grilloandrea6/Crazyflie_FPGA_Deck/Deck_FPGA.pdf

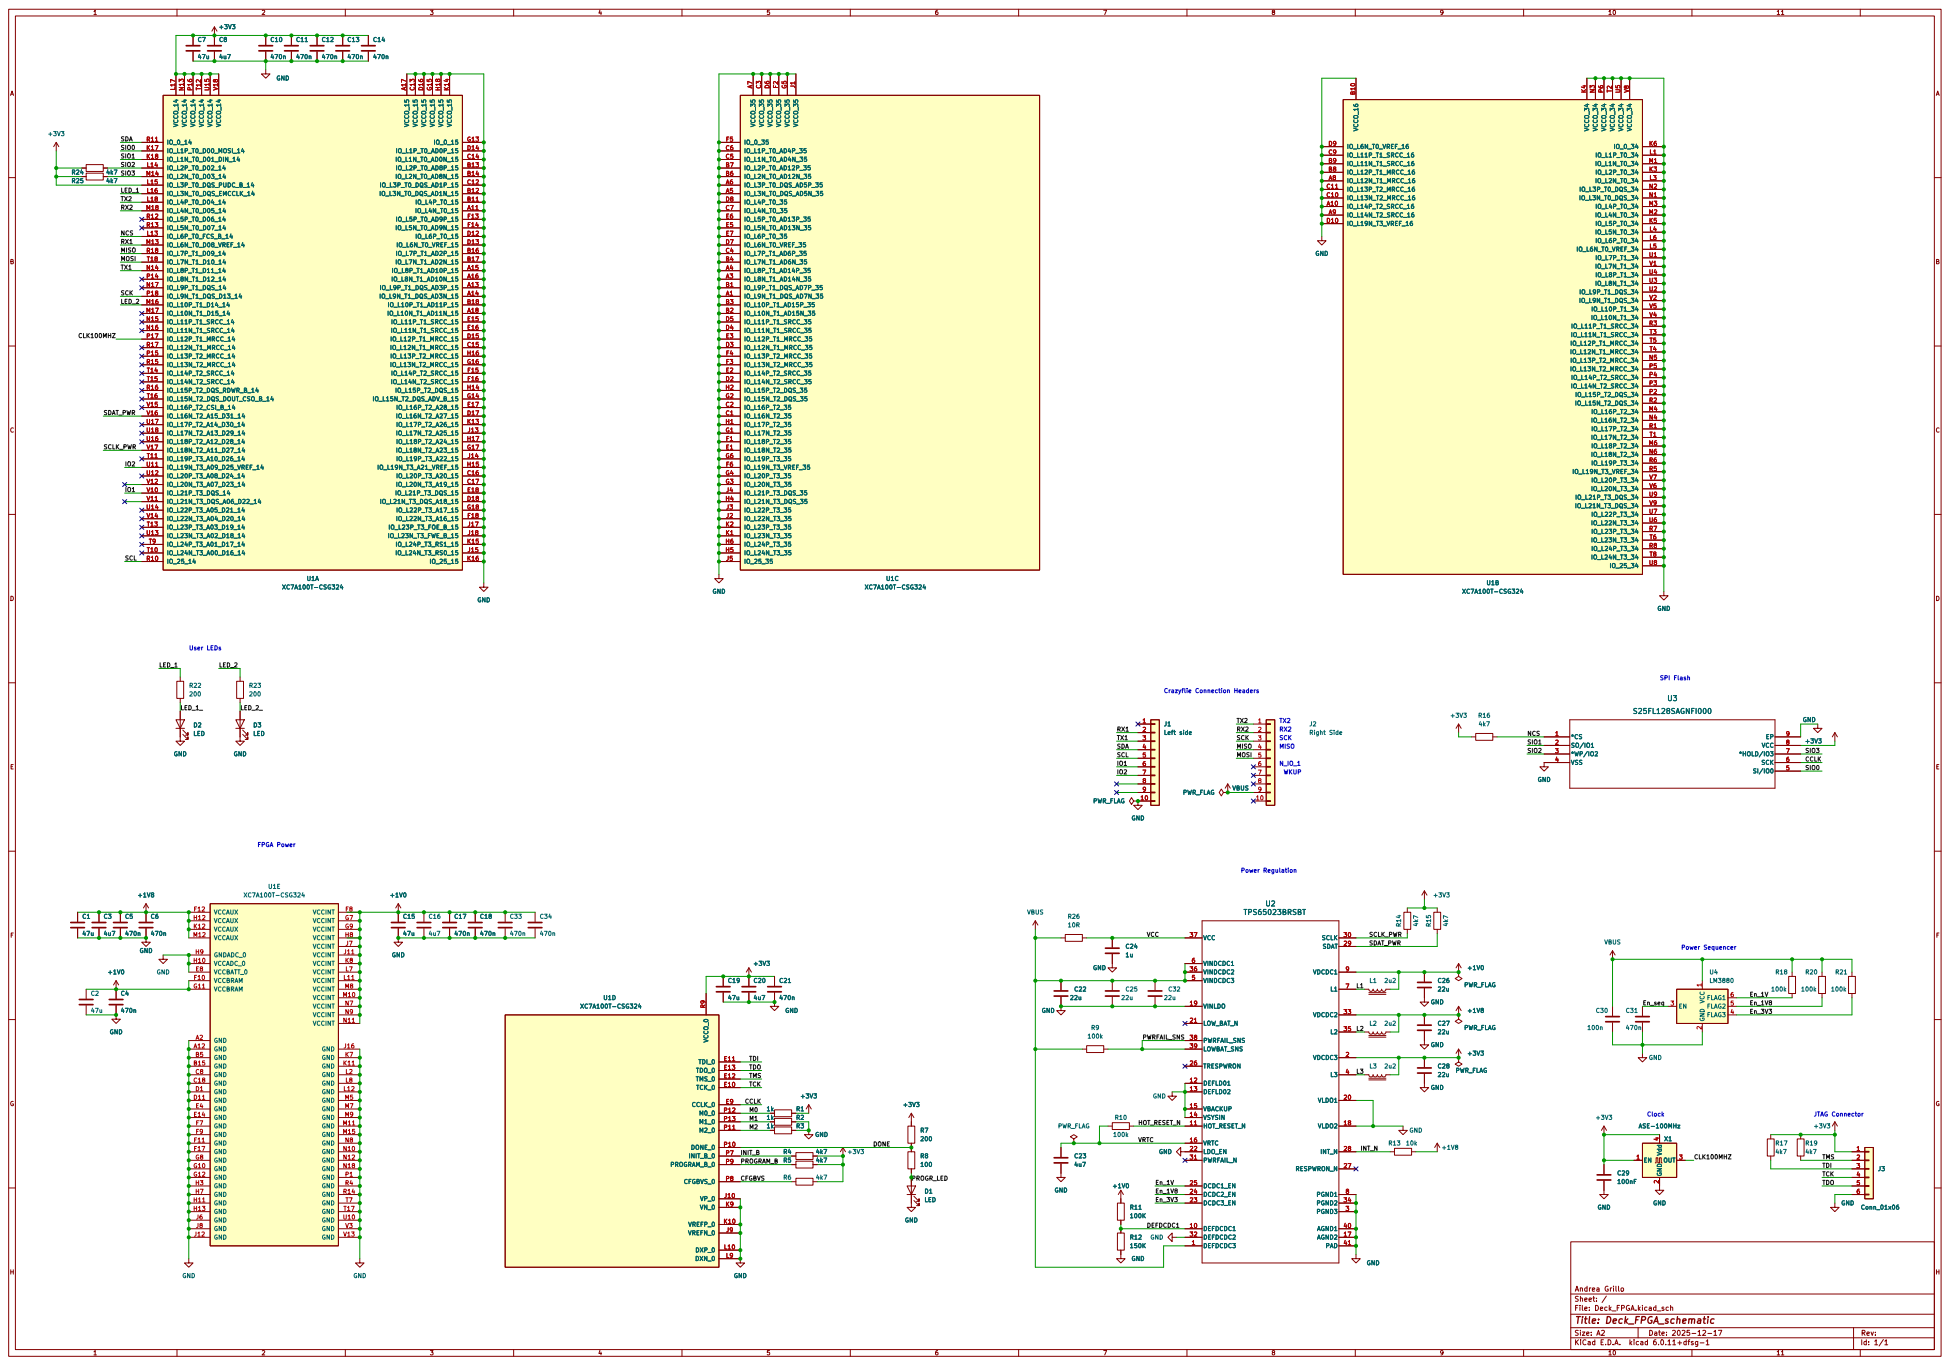
[picture p1: page 1]
