grilloandrea6/Crazyflie_FPGA_Deck/Deck_FPGA.kicad_pcb

## KiCad design Deck_FPGA.kicad_pcb (2026-01-14)

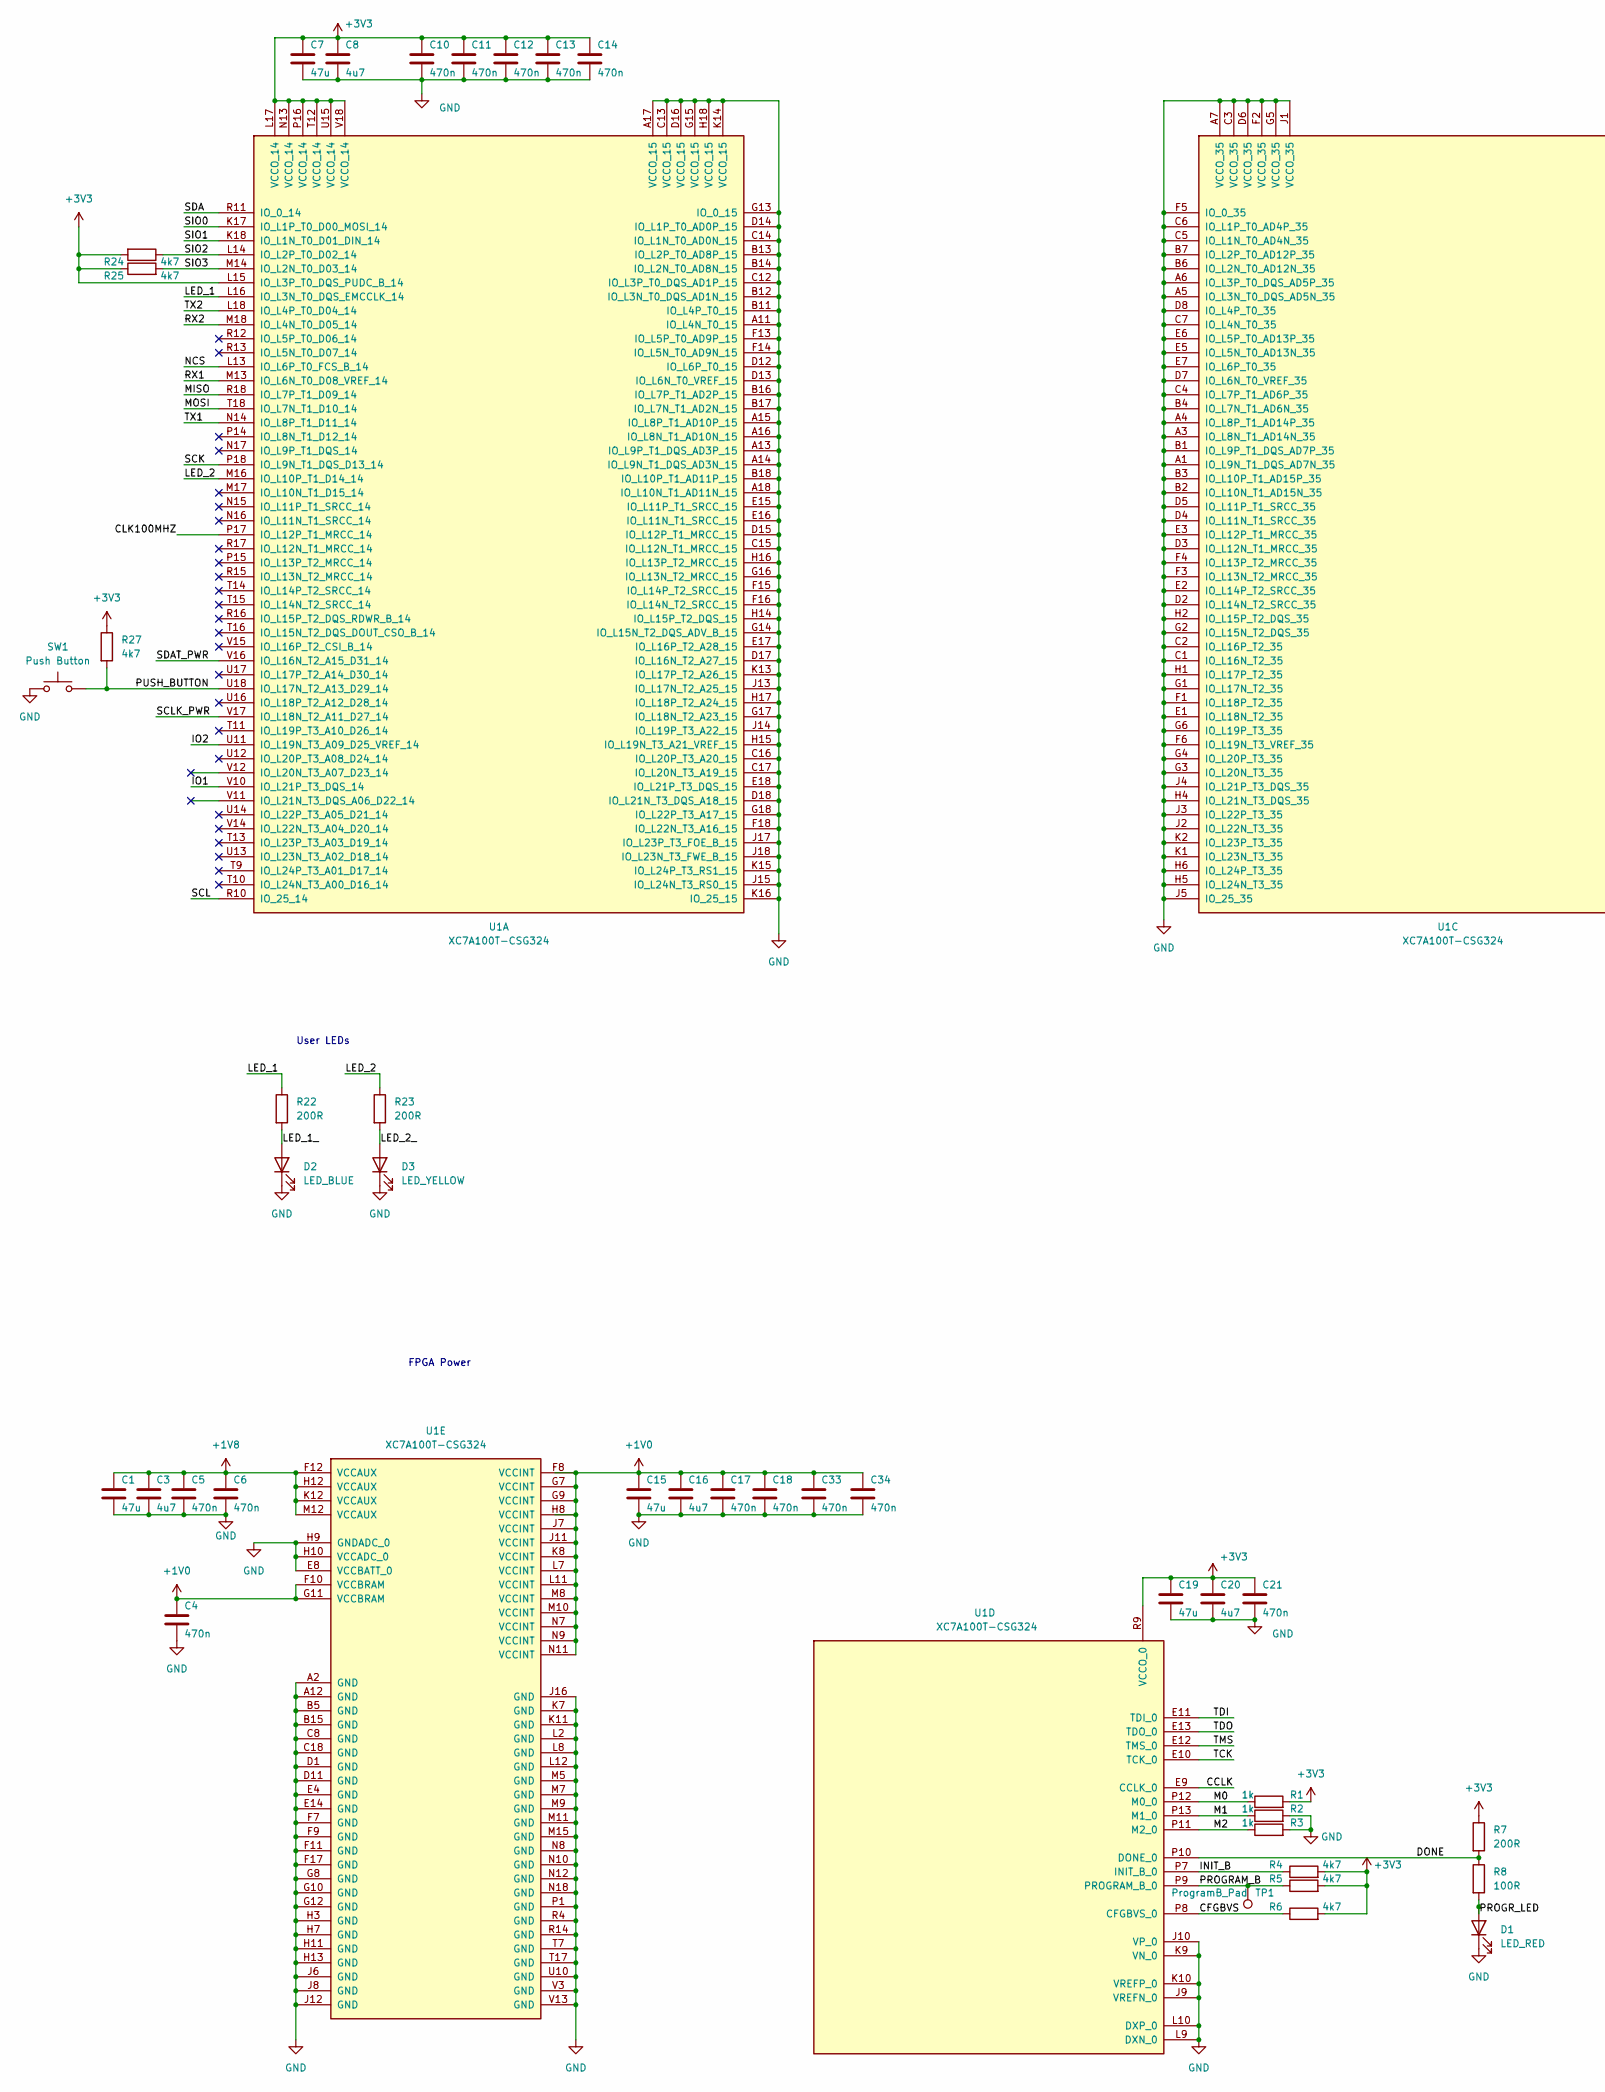
[picture p2: schematic Deck_FPGA.kicad_sch, Deck_FPGA_schematic, part in row 1, column 1]

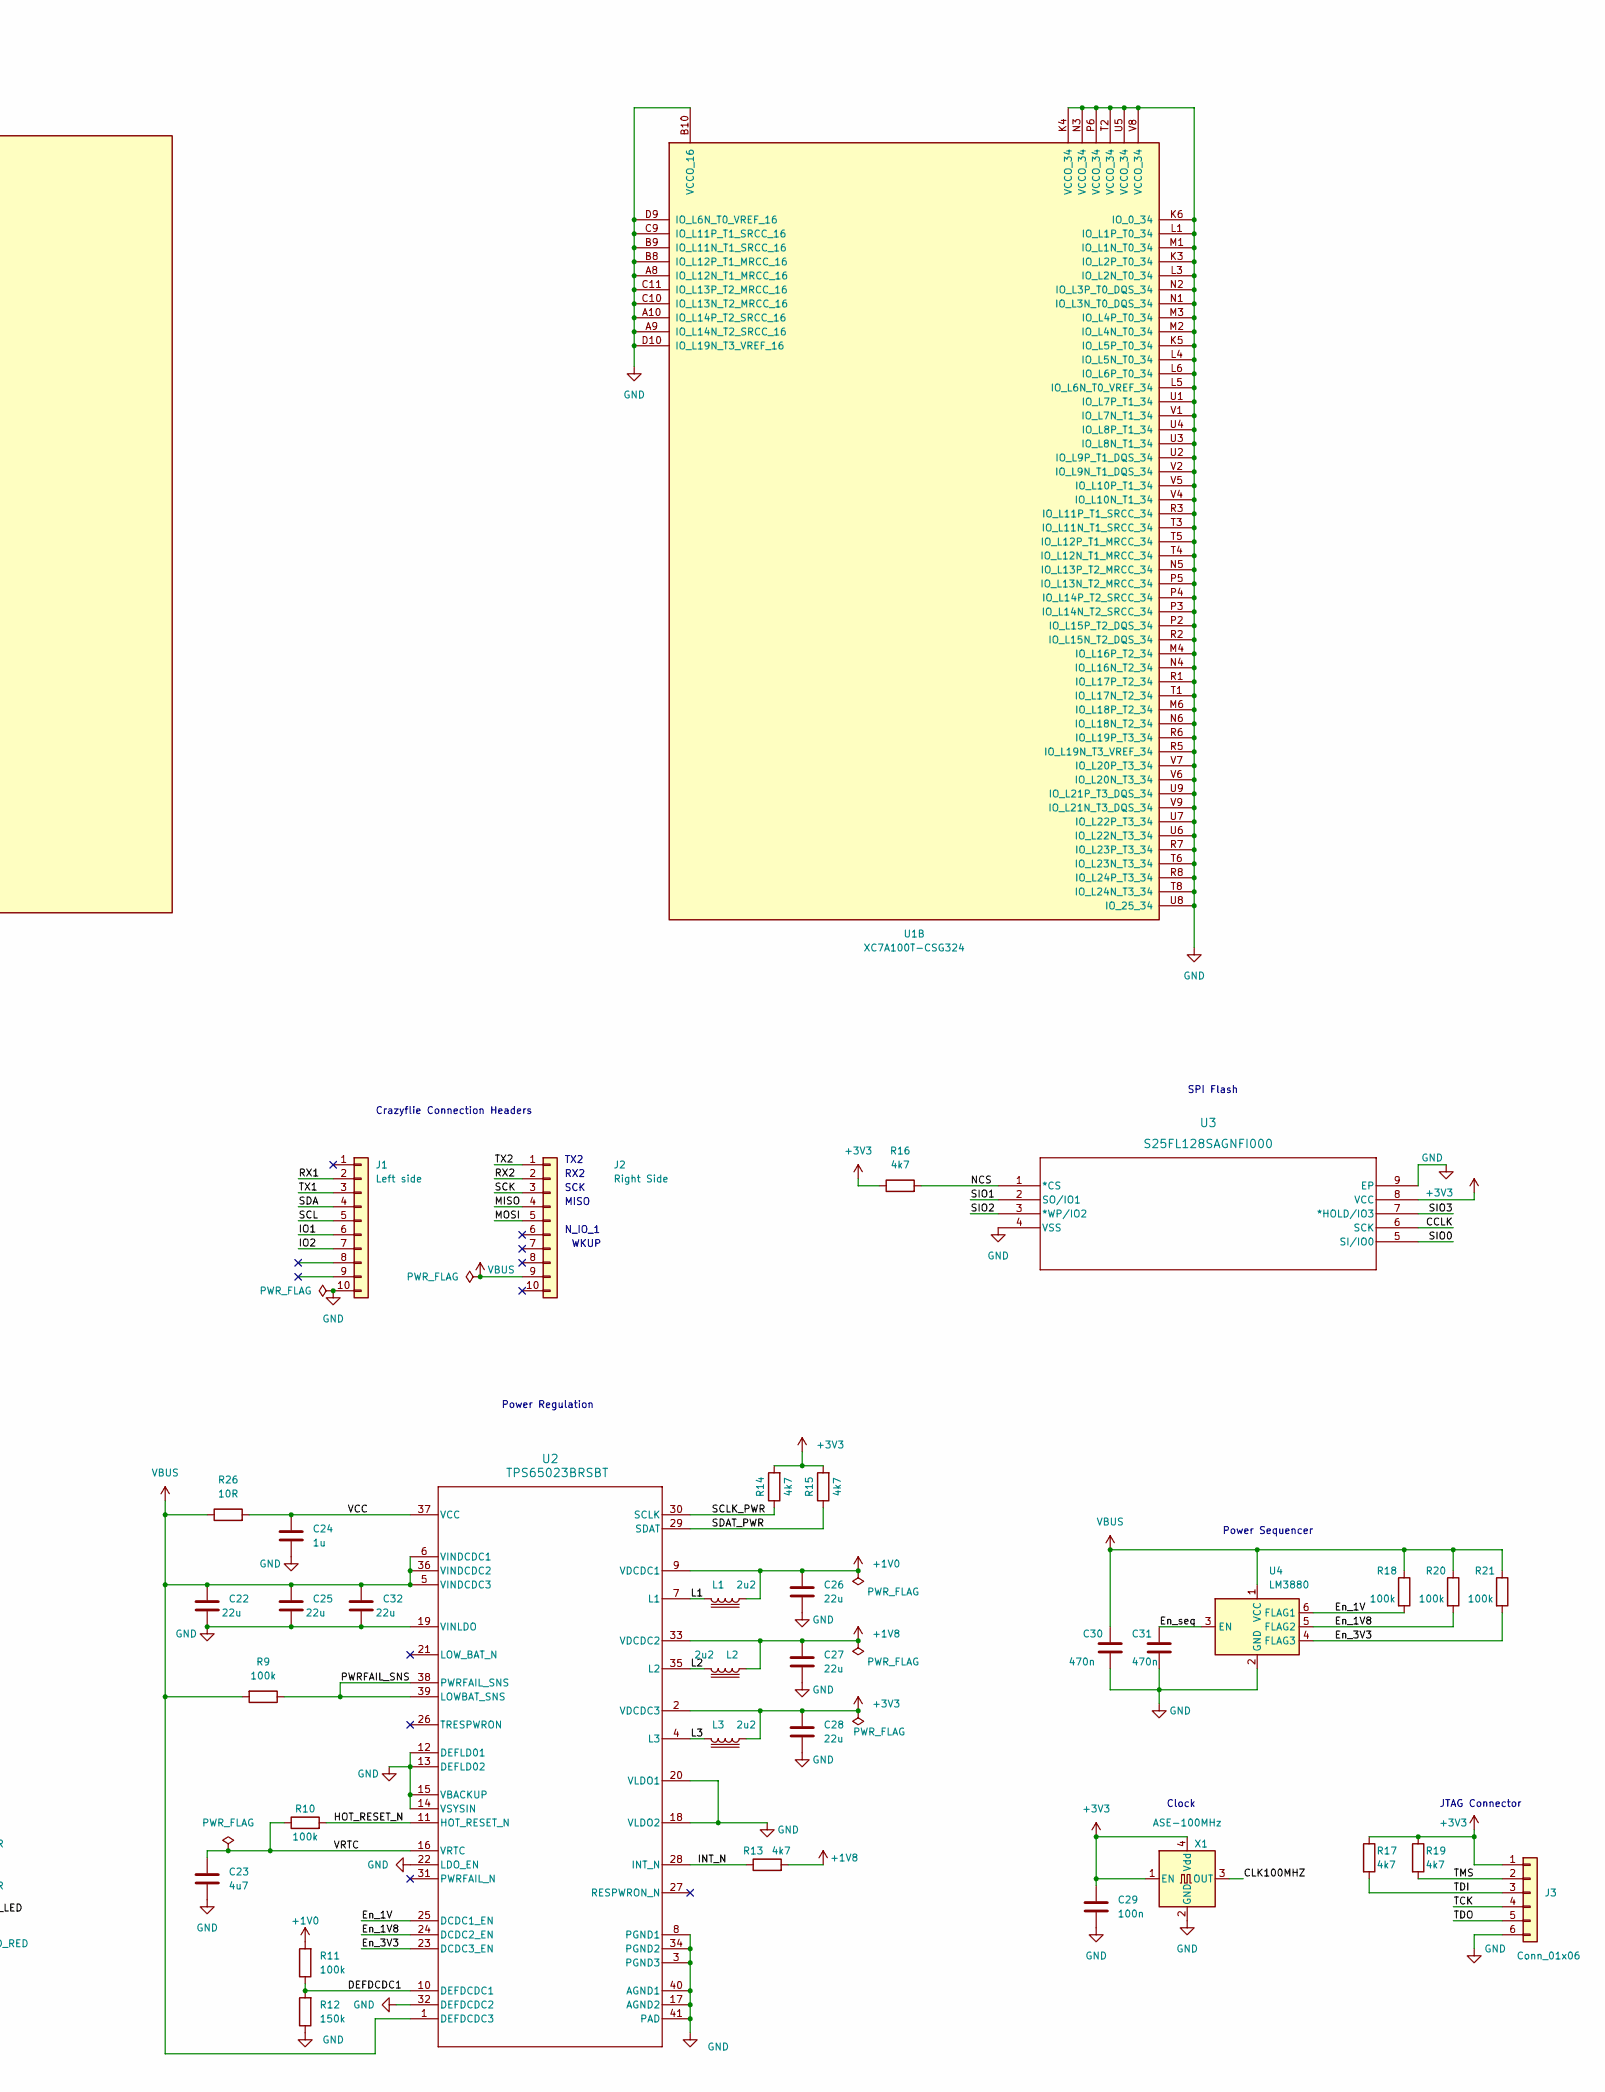
[picture p3: schematic Deck_FPGA.kicad_sch, Deck_FPGA_schematic, part in row 1, column 2]

Parts:
C1: 47u; C_0603_1608Metric; LCSC C140782
C3, C16: 4u7; C_0402_1005Metric; LCSC C23733
C4: 470n; C_0402_1005Metric; LCSC C106255
C5, C6, C10, C11, C12, C13, C14, C17, C18, C21, C30, C31, C33, C34: 470n; C_0402_1005Metric
C7, C15, C19: 47u; C_0603_1608Metric
C8, C20, C23: 4u7; C_0402_1005Metric
C22, C25: 22u; C_0603_1608Metric; LCSC C86295
C24: 1u; C_0603_1608Metric; LCSC C15849
C26, C27, C28, C32: 22u; C_0603_1608Metric
C29: 100n; C_0402_1005Metric; LCSC C60474
D1: LED_RED; LED_0603_1608Metric; LCSC C5879214
D2: LED_BLUE; LED_0603_1608Metric; LCSC C5879217
D3: LED_YELLOW; LED_0603_1608Metric; LCSC C5879216
J1: Left side; BF090-10-X-B2
J2: Right Side; BF090-10-X-B2
J3: Conn_01x06; PinHeader_1x06_P2.54mm_Vertical
L1: 2u2; IND_WE-PMCI_0806_WRE; LCSC C71386
L2, L3: 2u2; IND_WE-PMCI_0806_WRE
R1: 1k; R_0402_1005Metric; LCSC C11702
R2, R3: 1k; R_0402_1005Metric
R4: 4k7; R_0402_1005Metric; LCSC C25900
R5, R6, R13, R14, R15, R16, R17, R19, R24, R25, R27: 4k7; R_0402_1005Metric
R7: 200R; R_0402_1005Metric; LCSC C25087
R8: 100R; R_0402_1005Metric; LCSC C25076
R9: 100k; R_0402_1005Metric; LCSC C2906859
R10, R11, R18, R20, R21: 100k; R_0402_1005Metric
R12: 150k; R_0402_1005Metric; LCSC C2909320
R22, R23: 200R; R_0402_1005Metric
R26: 10R; R_0402_1005Metric; LCSC C413044
SW1: Push Button; SW_EVQ-P3401P; LCSC C79163
TP1: ProgramB_Pad; TestPoint_Pad_D1.0mm
U1: XC7A100T-CSG324; Xilinx_CSG324; LCSC C5181214
U2: TPS65023BRSBT; RSB0040B; LCSC C138723
U3: S25FL128SAGNFI000; WNG008_SPA; LCSC C22445046
U4: LM3880; SOT-23-6; LCSC C2650186
X1: ASE-100MHz; Oscillator_SMD_Abracon_ASE-4Pin_3.2x2.5mm; LCSC C596959

Connections:
+1V0: C4.1, C15.1, C16.1, C17.1, C18.1, C26.1, C33.1, C34.1, L1.1, R11.2, U1.F8 (VCCINT), U1.F10 (VCCBRAM), U1.G7 (VCCINT), U1.G9 (VCCINT), U1.G11 (VCCBRAM), U1.H8 (VCCINT), U1.J7 (VCCINT), U1.J11 (VCCINT), U1.K8 (VCCINT), U1.L7 (VCCINT), U1.L11 (VCCINT), U1.M8 (VCCINT), U1.M10 (VCCINT), U1.N7 (VCCINT), U1.N9 (VCCINT), U1.N11 (VCCINT), U2.9 (VDCDC1)
+1V8: C1.1, C3.1, C5.1, C6.1, C27.1, L2.2, R13.2, U1.F12 (VCCAUX), U1.H12 (VCCAUX), U1.K12 (VCCAUX), U1.M12 (VCCAUX), U2.33 (VDCDC2)
+3V3: C7.1, C8.1, C10.1, C11.1, C12.1, C13.1, C14.1, C19.1, C20.1, C21.1, C28.1, C29.1, J3.1, L3.1, R1.2, R4.2, R5.2, R6.2, R7.1, R14.2, R15.2, R16.1, R17.1, R19.1, R24.2, R25.1, R27.1, U1.L15 (IO_L3P_T0_DQS_PUDC_B_14), U1.L17 (VCCO_14), U1.N13 (VCCO_14), U1.P16 (VCCO_14), U1.R9 (VCCO_0), U1.T12 (VCCO_14), U1.U15 (VCCO_14), U1.V18 (VCCO_14), U2.2 (VDCDC3), U3.8 (VCC), X1.1 (EN), X1.4 (Vdd)
/CCLK: U1.E9 (CCLK_0), U3.6 (SCK)
/CFGBVS: R6.1, U1.P8 (CFGBVS_0)
/CLK100MHZ: U1.P17 (IO_L12P_T1_MRCC_14), X1.3 (OUT)
/DEFDCDC1: R11.1, R12.2, U2.10 (DEFDCDC1)
/DONE: R7.2, R8.1, U1.P10 (DONE_0)
/En_1V: R18.2, U2.25 (DCDC1_EN), U4.6 (FLAG1)
/En_1V8: R20.2, U2.24 (DCDC2_EN), U4.5 (FLAG2)
/En_3V3: R21.2, U2.23 (DCDC3_EN), U4.4 (FLAG3)
/En_seq: C31.1, U4.3 (EN)
/HOT_RESET_N: R10.2, U2.11 (HOT_RESET_N)
/INIT_B: R4.1, U1.P7 (INIT_B_0)
/INT_N: R13.1, U2.28 (INT_N)
/IO1: J1.6, U1.V10 (IO_L21P_T3_DQS_14)
/IO2: J1.7, U1.U11 (IO_L19N_T3_A09_D25_VREF_14)
/L1: L1.2, U2.7 (L1)
/L2: L2.1, U2.35 (L2)
/L3: L3.2, U2.4 (L3)
/LED_1: R22.1, U1.L16 (IO_L3N_T0_DQS_EMCCLK_14)
/LED_1_: D2.2 (A), R22.2
/LED_2: R23.1, U1.M16 (IO_L10P_T1_D14_14)
/LED_2_: D3.2 (A), R23.2
/M0: R1.1, U1.P12 (M0_0)
/M1: R2.1, U1.P13 (M1_0)
/M2: R3.1, U1.P11 (M2_0)
/MISO: J2.4, U1.R18 (IO_L7P_T1_D09_14)
/MOSI: J2.5, U1.T18 (IO_L7N_T1_D10_14)
/NCS: R16.2, U1.L13 (IO_L6P_T0_FCS_B_14), U3.1 (*CS)
/PROGRAM_B: R5.1, TP1.1, U1.P9 (PROGRAM_B_0)
/PROGR_LED: D1.2 (A), R8.2
/PUSH_BUTTON: R27.2, SW1.2, U1.U18 (IO_L17N_T2_A13_D29_14)
/PWRFAIL_SNS: R9.1, U2.38 (PWRFAIL_SNS), U2.39 (LOWBAT_SNS)
/RX1: J1.2, U1.M13 (IO_L6N_T0_D08_VREF_14)
/RX2: J2.2, U1.M18 (IO_L4N_T0_D05_14)
/SCK: J2.3, U1.P18 (IO_L9N_T1_DQS_D13_14)
/SCL: J1.5, U1.R10 (IO_25_14)
/SCLK_PWR: R14.1, U1.V17 (IO_L18N_T2_A11_D27_14), U2.30 (SCLK)
/SDA: J1.4, U1.R11 (IO_0_14)
/SDAT_PWR: R15.1, U1.V16 (IO_L16N_T2_A15_D31_14), U2.29 (SDAT)
/SIO0: U1.K17 (IO_L1P_T0_D00_MOSI_14), U3.5 (SI/IO0)
/SIO1: U1.K18 (IO_L1N_T0_D01_DIN_14), U3.2 (SO/IO1)
/SIO2: R24.1, U1.L14 (IO_L2P_T0_D02_14), U3.3 (*WP/IO2)
/SIO3: R25.2, U1.M14 (IO_L2N_T0_D03_14), U3.7 (*HOLD/IO3)
/TCK: J3.4, U1.E10 (TCK_0)
/TDI: J3.3, R17.2, U1.E11 (TDI_0)
/TDO: J3.5, U1.E13 (TDO_0)
/TMS: J3.2, R19.2, U1.E12 (TMS_0)
/TX1: J1.3, U1.N14 (IO_L8P_T1_D11_14)
/TX2: J2.1, U1.L18 (IO_L4P_T0_D04_14)
/VCC: C24.1, R26.2, U2.37 (VCC)
/VRTC: C23.1, R10.1, U2.16 (VRTC)
GND: C1.2, C3.2, C4.2, C5.2, C6.2, C7.2, C8.2, C10.2, C11.2, C12.2, C13.2, C14.2, C15.2, C16.2, C17.2, C18.2, C19.2, C20.2, C21.2, C22.2, C23.2, C24.2, C25.2, C26.2, C27.2, C28.2, C29.2, C30.2, C31.2, C32.2, C33.2, C34.2, D1.1 (K), D2.1 (K), D3.1 (K), J1.10, J3.6, R2.2, R3.2, R12.1, SW1.1, U1.A1 (IO_L9N_T1_DQS_AD7N_35), U1.A2 (GND), U1.A3 (IO_L8N_T1_AD14N_35), U1.A4 (IO_L8P_T1_AD14P_35), U1.A5 (IO_L3N_T0_DQS_AD5N_35), U1.A6 (IO_L3P_T0_DQS_AD5P_35), U1.A7 (VCCO_35), U1.A8 (IO_L12N_T1_MRCC_16), U1.A9 (IO_L14N_T2_SRCC_16), U1.A10 (IO_L14P_T2_SRCC_16), U1.A11 (IO_L4N_T0_15), U1.A12 (GND), U1.A13 (IO_L9P_T1_DQS_AD3P_15), U1.A14 (IO_L9N_T1_DQS_AD3N_15), U1.A15 (IO_L8P_T1_AD10P_15), U1.A16 (IO_L8N_T1_AD10N_15), U1.A17 (VCCO_15), U1.A18 (IO_L10N_T1_AD11N_15), U1.B1 (IO_L9P_T1_DQS_AD7P_35), U1.B2 (IO_L10N_T1_AD15N_35), U1.B3 (IO_L10P_T1_AD15P_35), U1.B4 (IO_L7N_T1_AD6N_35), U1.B5 (GND), U1.B6 (IO_L2N_T0_AD12N_35), U1.B7 (IO_L2P_T0_AD12P_35), U1.B8 (IO_L12P_T1_MRCC_16), U1.B9 (IO_L11N_T1_SRCC_16), U1.B10 (VCCO_16), U1.B11 (IO_L4P_T0_15), U1.B12 (IO_L3N_T0_DQS_AD1N_15), U1.B13 (IO_L2P_T0_AD8P_15), U1.B14 (IO_L2N_T0_AD8N_15), U1.B15 (GND), U1.B16 (IO_L7P_T1_AD2P_15), U1.B17 (IO_L7N_T1_AD2N_15), U1.B18 (IO_L10P_T1_AD11P_15), U1.C1 (IO_L16N_T2_35), U1.C2 (IO_L16P_T2_35), U1.C3 (VCCO_35), U1.C4 (IO_L7P_T1_AD6P_35), U1.C5 (IO_L1N_T0_AD4N_35), U1.C6 (IO_L1P_T0_AD4P_35), U1.C7 (IO_L4N_T0_35), U1.C8 (GND), U1.C9 (IO_L11P_T1_SRCC_16), U1.C10 (IO_L13N_T2_MRCC_16), U1.C11 (IO_L13P_T2_MRCC_16), U1.C12 (IO_L3P_T0_DQS_AD1P_15), U1.C13 (VCCO_15), U1.C14 (IO_L1N_T0_AD0N_15), U1.C15 (IO_L12N_T1_MRCC_15), U1.C16 (IO_L20P_T3_A20_15), U1.C17 (IO_L20N_T3_A19_15), U1.C18 (GND), U1.D1 (GND), U1.D2 (IO_L14N_T2_SRCC_35), U1.D3 (IO_L12N_T1_MRCC_35), U1.D4 (IO_L11N_T1_SRCC_35), U1.D5 (IO_L11P_T1_SRCC_35), U1.D6 (VCCO_35), U1.D7 (IO_L6N_T0_VREF_35), U1.D8 (IO_L4P_T0_35), U1.D9 (IO_L6N_T0_VREF_16), U1.D10 (IO_L19N_T3_VREF_16), U1.D11 (GND), U1.D12 (IO_L6P_T0_15), U1.D13 (IO_L6N_T0_VREF_15), U1.D14 (IO_L1P_T0_AD0P_15), U1.D15 (IO_L12P_T1_MRCC_15), U1.D16 (VCCO_15), U1.D17 (IO_L16N_T2_A27_15), U1.D18 (IO_L21N_T3_DQS_A18_15), U1.E1 (IO_L18N_T2_35), U1.E2 (IO_L14P_T2_SRCC_35), U1.E3 (IO_L12P_T1_MRCC_35), U1.E4 (GND), U1.E5 (IO_L5N_T0_AD13N_35), U1.E6 (IO_L5P_T0_AD13P_35), U1.E7 (IO_L6P_T0_35), U1.E8 (VCCBATT_0), U1.E14 (GND), U1.E15 (IO_L11P_T1_SRCC_15), U1.E16 (IO_L11N_T1_SRCC_15), U1.E17 (IO_L16P_T2_A28_15), U1.E18 (IO_L21P_T3_DQS_15), U1.F1 (IO_L18P_T2_35), U1.F2 (VCCO_35), U1.F3 (IO_L13N_T2_MRCC_35), U1.F4 (IO_L13P_T2_MRCC_35), U1.F5 (IO_0_35), U1.F6 (IO_L19N_T3_VREF_35), U1.F7 (GND), U1.F9 (GND), U1.F11 (GND), U1.F13 (IO_L5P_T0_AD9P_15), U1.F14 (IO_L5N_T0_AD9N_15), U1.F15 (IO_L14P_T2_SRCC_15), U1.F16 (IO_L14N_T2_SRCC_15), U1.F17 (GND), U1.F18 (IO_L22N_T3_A16_15), U1.G1 (IO_L17N_T2_35), U1.G2 (IO_L15N_T2_DQS_35), U1.G3 (IO_L20N_T3_35), U1.G4 (IO_L20P_T3_35), U1.G5 (VCCO_35), U1.G6 (IO_L19P_T3_35), U1.G8 (GND), U1.G10 (GND), U1.G12 (GND), U1.G13 (IO_0_15), U1.G14 (IO_L15N_T2_DQS_ADV_B_15), U1.G15 (VCCO_15), U1.G16 (IO_L13N_T2_MRCC_15), U1.G17 (IO_L18N_T2_A23_15), U1.G18 (IO_L22P_T3_A17_15), U1.H1 (IO_L17P_T2_35), U1.H2 (IO_L15P_T2_DQS_35), U1.H3 (GND), U1.H4 (IO_L21N_T3_DQS_35), U1.H5 (IO_L24N_T3_35), U1.H6 (IO_L24P_T3_35), U1.H7 (GND), U1.H9 (GNDADC_0), U1.H10 (VCCADC_0), U1.H11 (GND), U1.H13 (GND), U1.H14 (IO_L15P_T2_DQS_15), U1.H15 (IO_L19N_T3_A21_VREF_15), U1.H16 (IO_L13P_T2_MRCC_15), U1.H17 (IO_L18P_T2_A24_15), U1.H18 (VCCO_15), U1.J1 (VCCO_35), U1.J2 (IO_L22N_T3_35), U1.J3 (IO_L22P_T3_35), U1.J4 (IO_L21P_T3_DQS_35), U1.J5 (IO_25_35), U1.J6 (GND), U1.J8 (GND), U1.J9 (VREFN_0), U1.J10 (VP_0), U1.J12 (GND), U1.J13 (IO_L17N_T2_A25_15), U1.J14 (IO_L19P_T3_A22_15), U1.J15 (IO_L24N_T3_RS0_15), U1.J16 (GND), U1.J17 (IO_L23P_T3_FOE_B_15), U1.J18 (IO_L23N_T3_FWE_B_15), U1.K1 (IO_L23N_T3_35), U1.K2 (IO_L23P_T3_35), U1.K3 (IO_L2P_T0_34), U1.K4 (VCCO_34), U1.K5 (IO_L5P_T0_34), U1.K6 (IO_0_34), U1.K7 (GND), U1.K9 (VN_0), U1.K10 (VREFP_0), U1.K11 (GND), U1.K13 (IO_L17P_T2_A26_15), U1.K14 (VCCO_15), U1.K15 (IO_L24P_T3_RS1_15), U1.K16 (IO_25_15), U1.L1 (IO_L1P_T0_34), U1.L2 (GND), U1.L3 (IO_L2N_T0_34), U1.L4 (IO_L5N_T0_34), U1.L5 (IO_L6N_T0_VREF_34), U1.L6 (IO_L6P_T0_34), U1.L8 (GND), U1.L9 (DXN_0), U1.L10 (DXP_0), U1.L12 (GND), U1.M1 (IO_L1N_T0_34), U1.M2 (IO_L4N_T0_34), U1.M3 (IO_L4P_T0_34), U1.M4 (IO_L16P_T2_34), U1.M5 (GND), U1.M6 (IO_L18P_T2_34), U1.M7 (GND), U1.M9 (GND), U1.M11 (GND), U1.M15 (GND), U1.N1 (IO_L3N_T0_DQS_34), U1.N2 (IO_L3P_T0_DQS_34), U1.N3 (VCCO_34), U1.N4 (IO_L16N_T2_34), U1.N5 (IO_L13P_T2_MRCC_34), U1.N6 (IO_L18N_T2_34), U1.N8 (GND), U1.N10 (GND), U1.N12 (GND), U1.N18 (GND), U1.P1 (GND), U1.P2 (IO_L15P_T2_DQS_34), U1.P3 (IO_L14N_T2_SRCC_34), U1.P4 (IO_L14P_T2_SRCC_34), U1.P5 (IO_L13N_T2_MRCC_34), U1.P6 (VCCO_34), U1.R1 (IO_L17P_T2_34), U1.R2 (IO_L15N_T2_DQS_34), U1.R3 (IO_L11P_T1_SRCC_34), U1.R4 (GND), U1.R5 (IO_L19N_T3_VREF_34), U1.R6 (IO_L19P_T3_34), U1.R7 (IO_L23P_T3_34), U1.R8 (IO_L24P_T3_34), U1.R14 (GND), U1.T1 (IO_L17N_T2_34), U1.T2 (VCCO_34), U1.T3 (IO_L11N_T1_SRCC_34), U1.T4 (IO_L12N_T1_MRCC_34), U1.T5 (IO_L12P_T1_MRCC_34), U1.T6 (IO_L23N_T3_34), U1.T7 (GND), U1.T8 (IO_L24N_T3_34), U1.T17 (GND), U1.U1 (IO_L7P_T1_34), U1.U2 (IO_L9P_T1_DQS_34), U1.U3 (IO_L8N_T1_34), U1.U4 (IO_L8P_T1_34), U1.U5 (VCCO_34), U1.U6 (IO_L22N_T3_34), U1.U7 (IO_L22P_T3_34), U1.U8 (IO_25_34), U1.U9 (IO_L21P_T3_DQS_34), U1.U10 (GND), U1.V1 (IO_L7N_T1_34), U1.V2 (IO_L9N_T1_DQS_34), U1.V3 (GND), U1.V4 (IO_L10N_T1_34), U1.V5 (IO_L10P_T1_34), U1.V6 (IO_L20N_T3_34), U1.V7 (IO_L20P_T3_34), U1.V8 (VCCO_34), U1.V9 (IO_L21N_T3_DQS_34), U1.V13 (GND), U2.3 (PGND3), U2.8 (PGND1), U2.12 (DEFLD01), U2.13 (DEFLD02), U2.14 (VSYSIN), U2.15 (VBACKUP), U2.17 (AGND2), U2.18 (VLDO2), U2.19 (VINLDO), U2.20 (VLDO1), U2.22 (LDO_EN), U2.32 (DEFDCDC2), U2.34 (PGND2), U2.40 (AGND1), U2.41 (PAD), U3.4 (VSS), U3.9 (EP), U4.2 (GND), X1.2 (GND)
VBUS: C22.1, C25.1, C30.1, C32.1, J2.9, R9.2, R18.1, R20.1, R21.1, R26.1, U2.1 (DEFDCDC3), U2.5 (VINDCDC3), U2.6 (VINDCDC1), U2.36 (VINDCDC2), U4.1 (VCC)

Notes on the sheet:
RX2
TX2
User LEDs
Power Regulation
MISO
SCK
Crazyflie Connection Headers
FPGA Power
Clock
Power Sequencer
N_IO_1
JTAG Connector
WKUP
SPI Flash

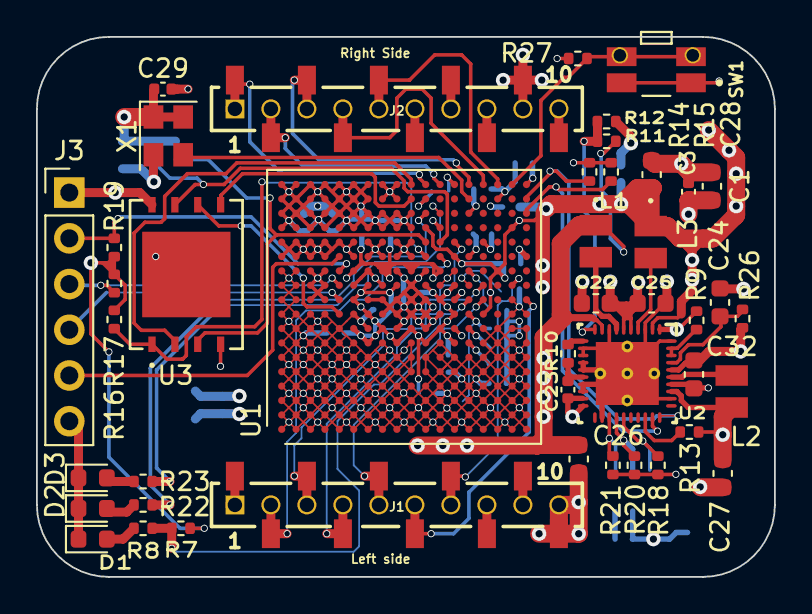
[picture p4: board Deck_FPGA.kicad_pcb from above]

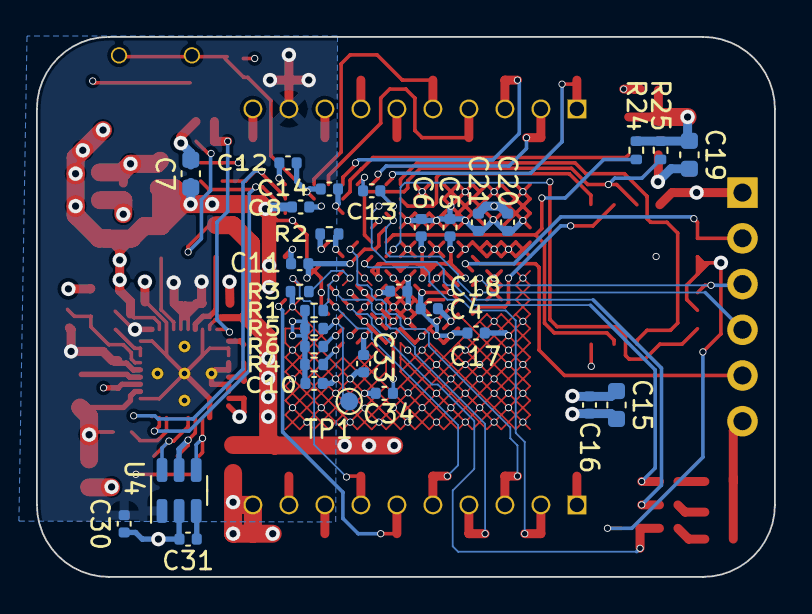
[picture p5: board Deck_FPGA.kicad_pcb from below]

Board: 4 copper layers, 41.0 x 30.0 mm, 75 parts (31 on the bottom side), 55 nets.
