grilloandrea6/Crazyflie_FPGA_Deck/(commit log)

2026-01-09 updated gerbers
    [Deck_FPGA-B_Cu.gbl, Deck_FPGA-B_Mask.gbs, Deck_FPGA-B_Paste.gbp, Deck_FPGA-B_Silkscreen.gbo, Deck_FPGA-Edge_Cuts.gm1, Deck_FPGA-F_Cu.gtl, Deck_FPGA-F_Mask.gts, Deck_FPGA-F_Paste.gtp]
2026-01-09 Add schematic PDF
2026-01-09 added PowerIC filtering resistor and pull up for SPI Flash SIO2/SIO3
    [Deck_FPGA-B_Cu.gbl, Deck_FPGA-B_Mask.gbs, Deck_FPGA-B_Paste.gbp, Deck_FPGA-B_Silkscreen.gbo, Deck_FPGA-Edge_Cuts.gm1, Deck_FPGA-F_Cu.gtl, Deck_FPGA-F_Mask.gts, Deck_FPGA-F_Paste.gtp]
2026-01-09 jlc references
    [Deck_FPGA.kicad_sch]
2026-01-09 fixed caps, jlc references
    [Deck_FPGA.kicad_pcb, Deck_FPGA.kicad_sch]
2026-01-09 fixed via size
    [Deck_FPGA-B_Cu.gbl, Deck_FPGA-B_Mask.gbs, Deck_FPGA-B_Paste.gbp, Deck_FPGA-B_Silkscreen.gbo, Deck_FPGA-Edge_Cuts.gm1, Deck_FPGA-F_Cu.gtl, Deck_FPGA-F_Mask.gts, Deck_FPGA-F_Paste.gtp]
2026-01-09 more modifications for jlc
    [Deck_FPGA-B_Cu.gbl, Deck_FPGA-B_Mask.gbs, Deck_FPGA-B_Paste.gbp, Deck_FPGA-B_Silkscreen.gbo, Deck_FPGA-Edge_Cuts.gm1, Deck_FPGA-F_Cu.gtl, Deck_FPGA-F_Mask.gts, Deck_FPGA-F_Paste.gtp]
2026-01-14 added testpad for program_b and user switch
    [Deck_FPGA-B_Cu.gbl, Deck_FPGA-B_Mask.gbs, Deck_FPGA-B_Paste.gbp, Deck_FPGA-B_Silkscreen.gbo, Deck_FPGA-Edge_Cuts.gm1, Deck_FPGA-F_Cu.gtl, Deck_FPGA-F_Mask.gts, Deck_FPGA-F_Paste.gtp]
2026-01-14 updated placement, bom
    [Deck_FPGA.csv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]
2026-01-14 final modifications, ordered!
    [Deck_FPGA-B_Cu.gbl, Deck_FPGA-B_Mask.gbs, Deck_FPGA-B_Paste.gbp, Deck_FPGA-B_Silkscreen.gbo, Deck_FPGA-Edge_Cuts.gm1, Deck_FPGA-F_Cu.gtl, Deck_FPGA-F_Mask.gts, Deck_FPGA-F_Paste.gtp]
2026-01-14 fixed issues after correct setup of DRC
    [Deck_FPGA-B_Cu.gbl, Deck_FPGA-B_Mask.gbs, Deck_FPGA-B_Paste.gbp, Deck_FPGA-B_Silkscreen.gbo, Deck_FPGA-Edge_Cuts.gm1, Deck_FPGA-F_Cu.gtl, Deck_FPGA-F_Mask.gts, Deck_FPGA-F_Paste.gtp]
2026-01-14 ordered 2nd time
    [Deck_FPGA-B_Cu.gbl, Deck_FPGA-B_Mask.gbs, Deck_FPGA-B_Paste.gbp, Deck_FPGA-B_Silkscreen.gbo, Deck_FPGA-Edge_Cuts.gm1, Deck_FPGA-F_Cu.gtl, Deck_FPGA-F_Mask.gts, Deck_FPGA-F_Paste.gtp]
